rehmi/BottleNode/NodeTest/nodes.csv

Node | Name
00 | esp32-3485188d8ad8
01 | esp32-3485188d9920
02 | esp32-34851891bfc4
03 | esp32-34851891bf58
04 | esp32-3485188da08c
05 | esp32-3485188caddc
06 | esp32-3485188d91a8
07 | esp32-34851891bc4c
08 | esp32-3485188d86b0
09 | esp32-34851891b4d8
10 | esp32-3485188f55c0
11 | esp32-3485188d8ad0
12 | esp32-34851891b4b4
13 | esp32-34851891bb1c
14 | esp32-34851891bed0
15 | esp32-3485188d897c
16 | esp32-34851891c810
