rehmi/BottleNode/TODO.md

# Capabilities to add

* local filesystem
* play stream from local file
* WebDAV to access local filesystem
* push local file to WebDAV server
* functions to open/close local file, start/stop recording from mic to file
