rehmi/BottleNode/hw/BottleNode/BottleNode-schematic.pdf

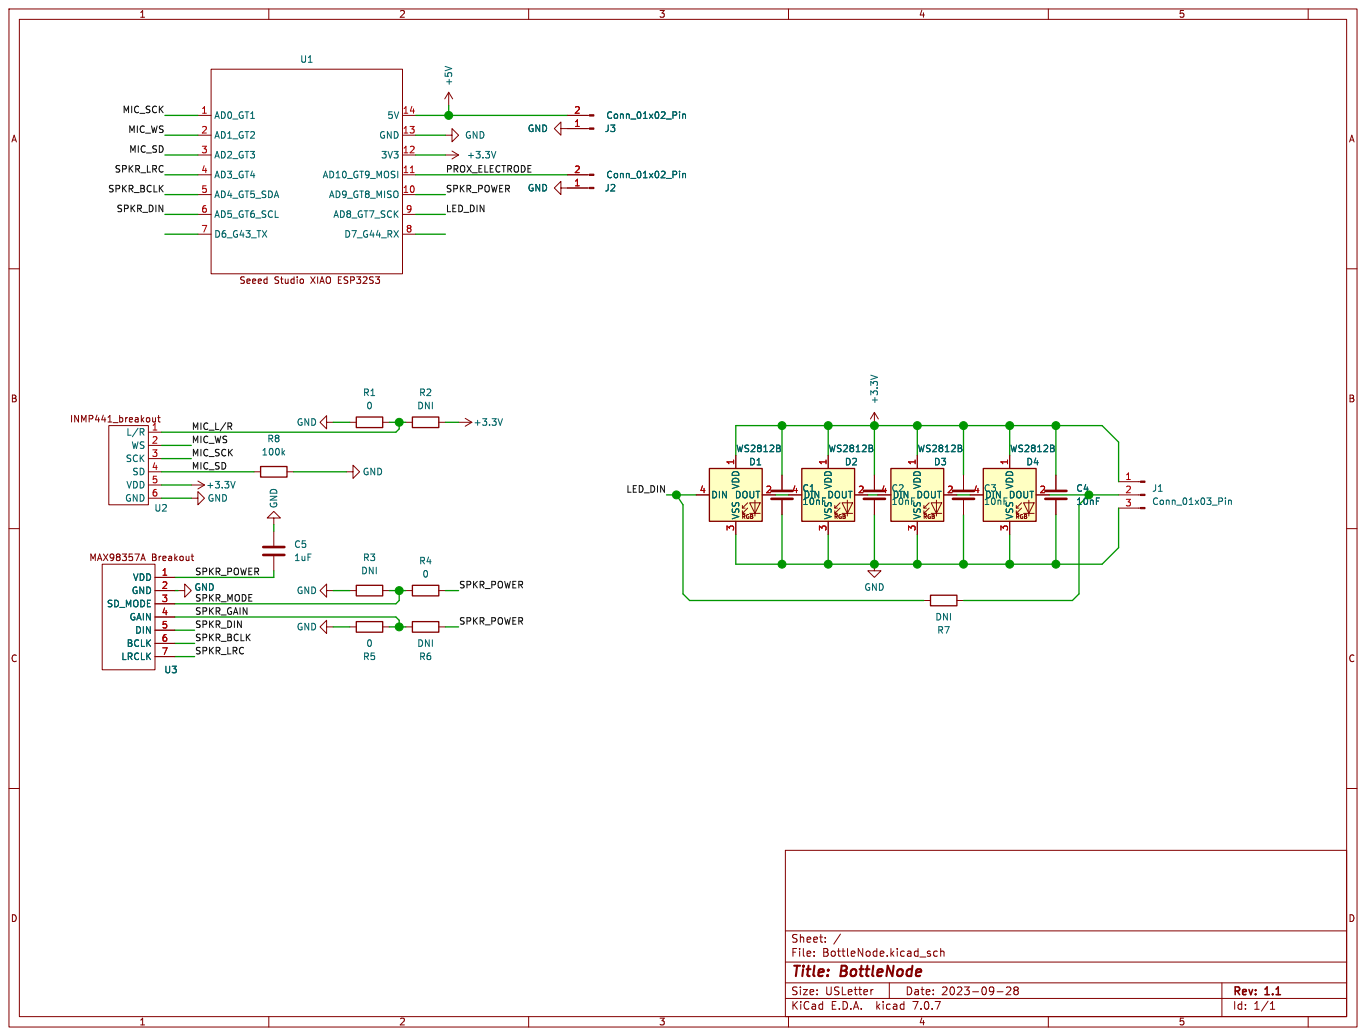
[picture p3: page 1]
