rehmi/BottleNode/hw/BottleNode/BottleNode.kicad_pcb

## KiCad design hw/BottleNode/BottleNode.kicad_pcb (2023-09-30)

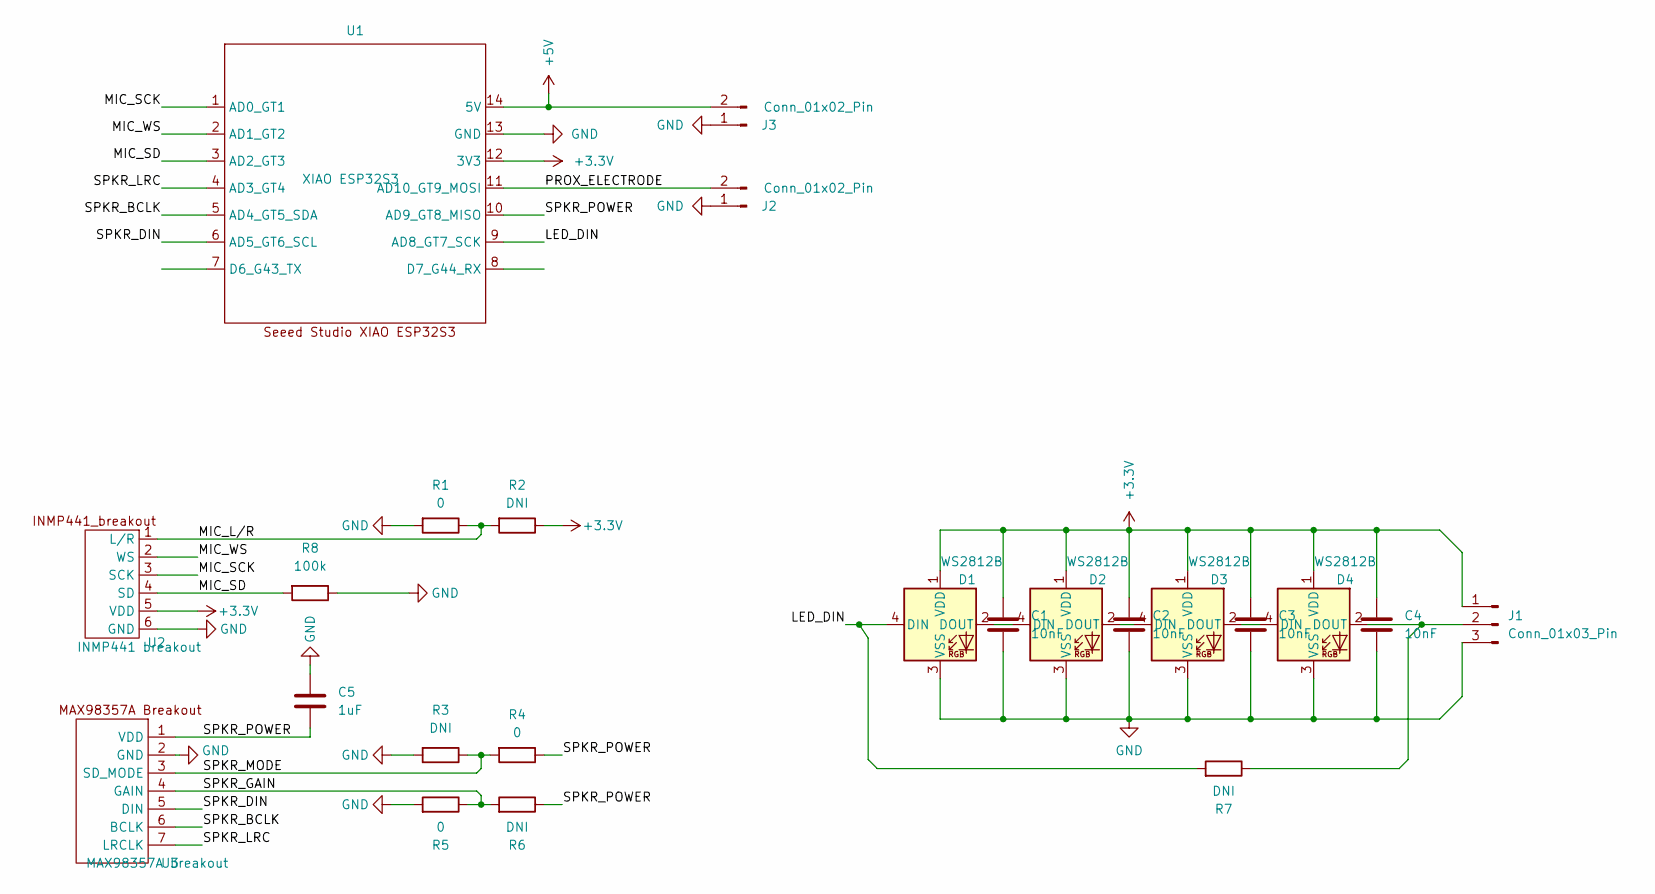
[picture p4: schematic BottleNode.kicad_sch]

Parts:
C1, C2, C3, C4: 10nF; C_0603_1608Metric_Pad1.08x0.95mm_HandSolder
C5: 1uF; C_0603_1608Metric_Pad1.08x0.95mm_HandSolder
D1, D2, D3, D4: WS2812B; LED_WS2812B_PLCC4_5.0x5.0mm_P3.2mm
J1: Conn_01x03_Pin; PinHeader_1x03_P2.54mm_Vertical
J2, J3: Conn_01x02_Pin; PinHeader_1x02_P2.54mm_Vertical
R1, R4, R5: 0; R_0603_1608Metric_Pad0.98x0.95mm_HandSolder
R2, R3, R6, R7: DNI; R_0603_1608Metric_Pad0.98x0.95mm_HandSolder
R8: 100k; R_0603_1608Metric_Pad0.98x0.95mm_HandSolder
U1: XIAO ESP32S3; XIAO-Generic-Thruhole-14P-2.54-21X17.8MM
U2: INMP441 breakout; INMP441_breakout
U3: MAX98357A breakout; MAX98357A_adafruit_breakout

Connections:
+3.3V: C1.1, C2.1, C3.1, C4.1, D1.1 (VDD), D2.1 (VDD), D3.1 (VDD), D4.1 (VDD), J1.1, R2.1, U1.12 (3V3), U2.5 (VDD)
+5V: J3.2, U1.14 (5V)
/LED_DIN: D1.4 (DIN), R7.2, U1.9 (AD8_GT7_SCK)
/MIC_L/R: R1.1, R2.2, U2.1 (L/R)
/MIC_SCK: U1.1 (AD0_GT1), U2.3 (SCK)
/MIC_SD: R8.2, U1.3 (AD2_GT3), U2.4 (SD)
/MIC_WS: U1.2 (AD1_GT2), U2.2 (WS)
/PROX_ELECTRODE: J2.2, U1.11 (AD10_GT9_MOSI)
/SPKR_BCLK: U1.5 (AD4_GT5_SDA), U3.6 (BCLK)
/SPKR_DIN: U1.6 (AD5_GT6_SCL), U3.5 (DIN)
/SPKR_GAIN: R5.1, R6.2, U3.4 (GAIN)
/SPKR_LRC: U1.4 (AD3_GT4), U3.7 (LRCLK)
/SPKR_MODE: R3.1, R4.2, U3.3 (SD_MODE)
/SPKR_POWER: C5.2, R4.1, R6.1, U1.10 (AD9_GT8_MISO), U3.1 (VDD)
GND: C1.2, C2.2, C3.2, C4.2, C5.1, D1.3 (VSS), D2.3 (VSS), D3.3 (VSS), D4.3 (VSS), J1.3, J2.1, J3.1, R1.2, R3.2, R5.2, R8.1, U1.13 (GND), U2.6 (GND), U3.2 (GND)
unnamed: D1.2 (DOUT), D2.4 (DIN)
unnamed: D2.2 (DOUT), D3.4 (DIN)
unnamed: D3.2 (DOUT), D4.4 (DIN)
unnamed: D4.2 (DOUT), J1.2, R7.1

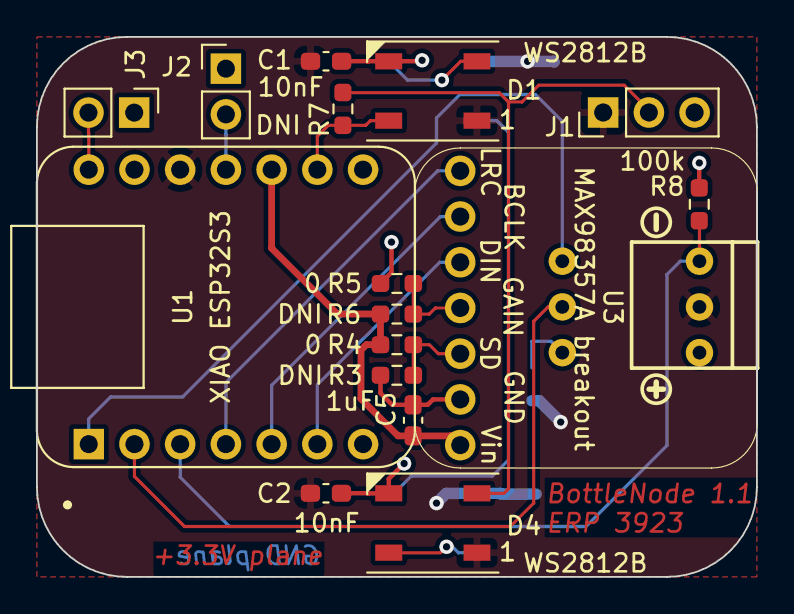
[picture p5: board BottleNode.kicad_pcb from above]

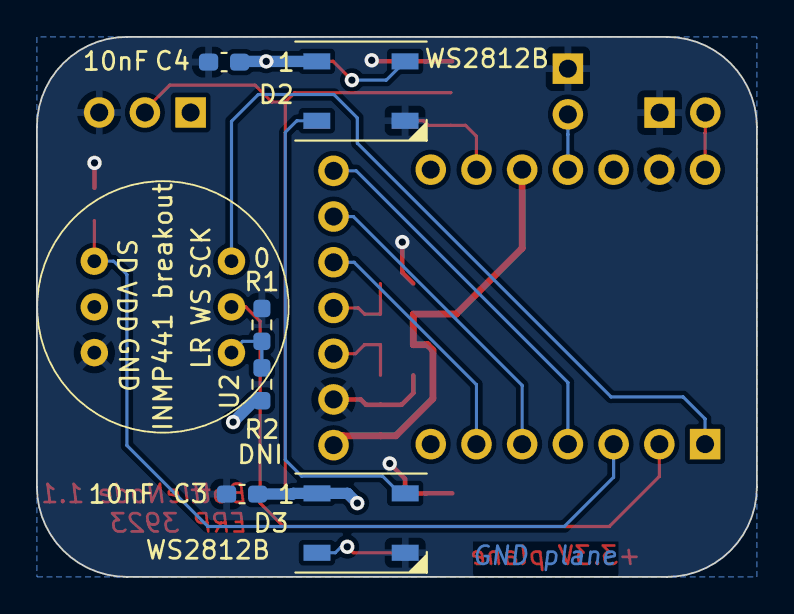
[picture p6: board BottleNode.kicad_pcb from below]

Board: 2 copper layers, 40.0 x 30.0 mm, 23 parts (7 on the bottom side), 19 nets.
