rehmi/BottleNode/Live/audio.cpp

#include "globals.h"
#include "FS.h"
#include "SPIFFS.h"
// Audio status functions
// Create audio object
Audio audio;
int fact = 50;
int dVal = 8*fact;
int toFade = 0;
int toLoop = 0;
char tFS[256];
char tFSC[256]="/C.mp3";
char tFSE[256]="/E.mp3";
char tFSG[256]="/G.mp3";
char tFSUse[256];

void listDir(fs::FS &fs, const char * dirname, uint8_t levels){
    Serial.printf("Listing directory: %s\r\n", dirname);

    File root = fs.open(dirname);
    if(!root){
        Serial.println("- failed to open directory");
        return;
    }
    if(!root.isDirectory()){
        Serial.println(" - not a directory");
        return;
    }

    File file = root.openNextFile();
    while(file){
        if(file.isDirectory()){
            Serial.print("  DIR : ");
            Serial.println(file.name());
            if(levels){
                listDir(fs, file.path(), levels -1);
            }
        } else {
            Serial.print("  FILE: ");
            Serial.print(file.name());
            Serial.print("\tSIZE: ");
            Serial.println(file.size());
        }
        file = root.openNextFile();
    }
}

bool check_if_file_exists(fs::FS &fs, const char *fName)  {
  bool exists = false;
  Serial.printf("Checking file exists: %s\r\n", fName);

    File file = fs.open(fName);
    if(!file){
        Serial.println("- failed to find file");
    } else{
      exists = true;
    }
    file.close();
    return exists;
}

void audio_info(const char *info) {
    Serial.print("info        ");
    Serial.println(info);
}
void audio_id3data(const char *info) {  // id3 metadata
    Serial.print("id3data     ");
    Serial.println(info);
}
void audio_eof_mp3(const char *info) {  // end of file
    Serial.print("eof_mp3     ");
    Serial.println(info);
}
void audio_showstation(const char *info) {
    Serial.print("station     ");
    Serial.println(info);
}
void audio_showstreaminfo(const char *info) {
    Serial.print("streaminfo  ");
    Serial.println(info);
}
void audio_showstreamtitle(const char *info) {
    Serial.print("streamtitle ");
    Serial.println(info);
}
void audio_bitrate(const char *info) {
    Serial.print("bitrate     ");
    Serial.println(info);
}
void audio_commercial(const char *info) {  // duration in sec
    Serial.print("commercial  ");
    Serial.println(info);
}
void audio_icyurl(const char *info) {  // homepage
    Serial.print("icyurl      ");
    Serial.println(info);
}
void audio_lasthost(const char *info) {  // stream URL played
    Serial.print("lasthost    ");
    Serial.println(info);
}
void audio_eof_speech(const char *info) {
    Serial.print("eof_speech  ");
    Serial.println(info);
}

void set_audio_url(char * in, int len) {
  char url[len];
  toFade = 0;
  Serial.println("Connecting to host: ");
  for(int i = 0; i < len; i++) {
        url[i]=in[i];
    }
  audio.connecttohost(url);
}

void set_audio_fs(char * in, int len) {
  char url[len];
  toFade = 0;
  toLoop = 1;
  Serial.println("Connecting to host: ");
  for(int i = 0; i < len; i++) {
        url[i]=in[i];
    }
  strcpy(tFSUse, url);
  audio.connecttoFS(SPIFFS, tFSUse); // SPIFFS

  Serial.println("Playing FS: ");
  Serial.println(tFSUse);
}

void set_audio_volume(uint8_t * in) {
    audio.setVolume(*in);
}

int fade_out() {
  toFade = 1;
  int off = 0;
  int vol = audio.getVolume();
  float div = (float)dVal/(float)fact;
  audio.setVolume((int)div);
  dVal--;
  if (vol <= 0) {
    off = 1;
  } 
  return off;
}

void stop_audio(void) {
    if (audio.isRunning())  {
      // fade_out();
      toFade = 1;
      toLoop = 0;
      audio.stopSong();
    }
}

void setup_audio(void)
{
    strcpy(tFSUse, tFSC);
    digitalWrite(SPKR_POWER, 0);
    gpio_set_drive_capability(SPKR_POWER, GPIO_DRIVE_CAP_3);
    pinMode(SPKR_POWER, OUTPUT);
    digitalWrite(SPKR_POWER, 1);

    // Connect MAX98357 I2S Amplifier Module
    audio.setPinout(SPKR_BCLK, SPKR_LRC, SPKR_DIN);

    // Set thevolume (0-100)
    audio.setVolume(18);

    audio.setConnectionTimeout(15000, 15000);

    // Connect to an Internet radio station (select one as desired)
    // audio.connecttohost("http://vis.media-ice.musicradio.com/CapitalMP3");
    // audio.connecttohost("mediaserv30.live-nect MAX98357 I2S Amplifier Module
    // audio.connecttohost("www.surfmusic.de/m3u/100-5-das-hitradio,4529.m3u");
    // audio.connecttohost("stream.1a-webradio.de/deutsch/mp3-128/vtuner-1a");
    // audio.connecttohost("www.antenne.de/webradio/antenne.m3u");
    // audio.connecttohost("0n-80s.radionetz.de:8000/0n-70s.mp3");

    char URL[] =
        // "http://stream.klassikradio.de/purebach/mp3-128/www.klassikradio.de/";
        // "http://ice1.somafm.com/deepspaceone-64-aac";
        // "http://ice1.somafm.com/dronezone-128-mp3";
        "https://ice4.somafm.com/dronezone-32-aac";
    // "http://38.96.148.28:8342/stream";
        audio.connecttohost(URL);

    #define FORMAT_SPIFFS_IF_FAILED true

    if(!SPIFFS.begin(FORMAT_SPIFFS_IF_FAILED)){
        Serial.println("SPIFFS Mount Failed");
        return;
    }
    
    listDir(SPIFFS, "/", 0);

    // Check if file exists 
    if(!check_if_file_exists(SPIFFS, tFSUse))  {
        strcpy(tFSUse, tFSE);
        audio.setVolume(15);
      if (!check_if_file_exists(SPIFFS, tFSE))  {
        strcpy(tFSUse, tFSG);
        audio.setVolume(15);
      }
      if (!check_if_file_exists(SPIFFS, tFSG))  {
        audio.setVolume(8);
      }
    }

    //  *** radio streams ***
    // while (!audio.connecttohost(URL))
    //     ;

    //  audio.connecttohost("http://stream.antennethueringen.de/live/aac-64/stream.antennethueringen.de/"); // aac
    //  audio.connecttohost("http://mcrscast.mcr.iol.pt/cidadefm");                                         // mp3
    //  audio.connecttohost("http://www.wdr.de/wdrlive/media/einslive.m3u");                                // m3u
    //  audio.connecttohost("https://stream.srg-ssr.ch/rsp/aacp_48.asx");                                   // asx
    //  audio.connecttohost("http://tuner.classical102.com/listen.pls");                                    // pls
    //  audio.connecttohost("http://stream.radioparadise.com/flac");                                        // flac
    //  audio.connecttohost("http://stream.sing-sing-bis.org:8000/singsingFlac");                           // flac (ogg)
    //  audio.connecttohost("http://s1.knixx.fm:5347/dein_webradio_vbr.opus");                              // opus (ogg)
    //  audio.connecttohost("http://stream2.dancewave.online:8080/dance.ogg");                              // vorbis (ogg)
    //  audio.connecttohost("http://26373.live.streamtheworld.com:3690/XHQQ_FMAAC/HLSTS/playlist.m3u8");    // HLS
    //  audio.connecttohost("http://eldoradolive02.akamaized.net/hls/live/2043453/eldorado/master.m3u8");   // HLS (ts)
    //  *** web files ***
    //  audio.connecttohost("https://github.com/schreibfaul1/ESP32-audioI2S/raw/master/additional_info/Testfiles/Pink-Panther.wav");        // wav
    //  audio.connecttohost("https://github.com/schreibfaul1/ESP32-audioI2S/raw/master/additional_info/Testfiles/Santiano-Wellerman.flac"); // flac
    //  audio.connecttohost("https://github.com/schreibfaul1/ESP32-audioI2S/raw/master/additional_info/Testfiles/Olsen-Banden.mp3");        // mp3
    //  audio.connecttohost("https://github.com/schreibfaul1/ESP32-audioI2S/raw/master/additional_info/Testfiles/Miss-Marple.m4a");         // m4a (aac)
    //  audio.connecttohost("https://github.com/schreibfaul1/ESP32-audioI2S/raw/master/additional_info/Testfiles/Collide.ogg");             // vorbis
    //  audio.connecttohost("https://github.com/schreibfaul1/ESP32-audioI2S/raw/master/additional_info/Testfiles/sample.opus");             // opus
    //  *** local files ***
    //  audio.connecttoFS(SD, "/test.wav");     // SD
    //  audio.connecttoFS(SD_MMC, "/test.wav"); // SD_MMC
    //  audio.connecttoFS(SPIFFS, "/test.wav"); // SPIFFS

    //  audio.connecttospeech("Wenn die Hunde schlafen, kann der Wolf gut Schafe stehlen.", "de"); // Google TTS


}

void loop_audio(void)
{   
    // Set thevolume (0-100)
    // audio.setVolume(min(6, (int)(touchfactor *  12)));
    audio.loop();

    if (touchfactor > 0.75)  {
      if(check_if_file_exists(SPIFFS, tFSUse))  {
        audio.connecttoFS(SPIFFS, tFSUse); // SPIFFS 
      } else  {
        audio.connecttospeech("Hello there!", "en"); // Google TTS
      }
    }

    if(toLoop == 1){
      Serial.println("restarting audio loop FS");
      if (!audio.isRunning()) {
      audio.connecttoFS(SPIFFS, tFSUse); // SPIFFS 
      }
    }

    // Ensure there is always music
    if (!audio.isRunning()) {
      audio.connecttoFS(SPIFFS, "default.aac"); // SPIFFS 
    }

    // Run audio player
    // if (toFade == 0)  {
    //   audio.loop();
    // }

    // Check if need to fade off 
    // if (toFade == 1)  {
    //   int off = fade_out();
    //   if (off == 1 )  {
    //     toFade = 0;
    //     dVal = 8*fact;
    //     audio.stopSong();
    //   }
    // }
}
