rehmi/BottleNode/Live/webdav.cpp

#include "globals.h"

/*
    Copyright (c) 2018 Gurpreet Bal https://github.com/ardyesp/ESPWebDAV
    Copyright (c) 2020 David Gauchard https://github.com/d-a-v/ESPWebDAV
    All rights reserved.

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
    1. Redistributions of source code must retain the above copyright notice,
      this list of conditions and the following disclaimer.
    2. Redistributions in binary form must reproduce the above copyright notice,
      this list of conditions and the following disclaimer in the documentation
      and/or other materials provided with the distribution.
    3. The name of the author may not be used to endorse or promote products
      derived from this software without specific prior written permission.

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
*/

/*  Using the WebDAV server

    From windows file explorer,
        \\ESPWebDAV.local\
        or http://ESPWebDAV.local/
        or Map Network Drive -> Connect to http://ESPWebDAV.local/
           subst w: \\ESPWebDAV.local/DavWWWRoot
    From macOS Finder > command-K > http://ESPWebDAV.local/
        (do not select anonymous to have write access)
    From macOS cmdline:
        mkdir -p /tmp/esp; mount_webdav -S -i -v esp32 http://ESPWebDAV.local/ /tmp/esp && echo OK
    From linux:
        use mount -t davs2 http://ESPWebDAV.local/ /mnt/
        use gio/gvfs/nautilus/YourFileExplorer http://ESPWebDAV.local/

    When running emulation on host (script ./run), use one of these URLs instead:
        http://ESPWebDAV.local:9080/
        http://127.0.0.1:9080/
        http://local-ip-address:9080/
        subst w: \\ESPWebDAV.local@9080/DavWWWRoot
*/

#include <WiFi.h>
#include <ESPmDNS.h>
#include <SPIFFS.h>
//#include <LITTLEFS.h>
#include <ESPWebDAV.h>

//FS& gfs = LITTLEFS;
//#define FILESYSTEM LITTLEFS
#define FILESYSTEM SPIFFS

//WiFiServerSecure tcp(443);
WiFiServer tcp(80);

ESPWebDAV dav;

// ------------------------
void setup_webdav()
{
    // MDNS.begin("ESPWebDAV");

    FILESYSTEM.begin();
    tcp.begin();
    dav.begin(&tcp, &FILESYSTEM);
    dav.setTransferStatusCallback([](const char* name, int percent, bool receive)
    {
        Serial.printf("%s: '%s': %d%%\n", receive ? "recv" : "send", name, percent);
    });

    Serial.println("WebDAV server started");
}

void help()
{
    Serial.printf("interactive: F/ormat D/ir C/reateFile\n");

    Serial.printf("Heap stats: free heap: %u\n",
                  ESP.getHeapSize());
}

// ------------------------
void loop_webdav()
{
    dav.handleClient();

    int c = Serial.read();
    if (c > 0)
    {
        if (c == 'F')
        {
            Serial.println("formatting...");
            if (FILESYSTEM.format())
                Serial.println("Success");
            else
                Serial.println("Failure");
        }
        else if (c == 'D')
        {
            Serial.printf(">>>>>>>> dir /\n");
            dav.dir("/", &Serial);
            Serial.printf("<<<<<<<< dir\n");
        }
        else if (c == 'C')
        {
            auto f = FILESYSTEM.open("/readme.md", "w");
            f.printf("hello\n");
            f.close();
        }
        else
            help();
    }

    // ------------------------
}
