rehmi/BottleNode/(commit log)

2023-09-19 preliminary schematic and PCB layout
    [BottleNode.kicad_pcb, BottleNode.kicad_sch]
2023-09-19 schematic and code fragments now agree on pinouts
    [BottleNode.kicad_pcb, BottleNode.kicad_sch]
2023-09-21 AllInOne_test = I2S passthru + LEDs + cap sensing
2023-09-21 swap SPKR_POWER/TOUCH_PIN in AllInOne_test/sch/pcb
    [BottleNode.kicad_pcb, BottleNode.kicad_sch]
2023-09-28 update LED behavior in OSC.cpp stub
2023-09-28 update BottleNode-schematic.pdf to match .sch file
2023-09-28 pin defs now in globals.h; added myAudioI2S.cpp
2023-09-29 rev 1.1 of schematic and PCB layout with BOM
    [BottleNode.csv, BottleNode.kicad_pcb, BottleNode.kicad_sch]
2023-09-29 updated schematic PDF and 3D renderings
2023-09-29 final tweaks on PCB v1.1
    [BottleNode.kicad_pcb, BottleNode.kicad_sch]
2023-09-30 rev 1.1.1 - move config resistors away from header
    [BottleNode.kicad_pcb, BottleNode.kicad_sch]
2023-10-04 Functional LED/Wifi
    Function WIFI and LED on my local esp32.
2023-10-06 Adding in IP addrss getting from arduino and max
2023-10-09 Adding batch send to send commands to all devices rather than just one
2023-10-09 Adding a pusher for current IP addresses as they respond to a request to identify
2023-10-11 Adding in capability for touchfactor feedback. Also fixed bug with loop_i2s(). Also cleaned up Max layout. And separated the commands so they are ip specific.
    [OSCL.cpp, WiFi_OTA.cpp, globals.h, touch.cpp]
2023-10-11 Removing IP address fixing and Adding sound tracks
    [Live.ino, OSCL.cpp, WiFi_OTA.cpp, audio.cpp, globals.h, touch.cpp]
2023-10-12 AllInOne_test for initial group testing
    [nodes.csv]
2023-10-12 switch to 32kbps test stream
2023-10-12 NodeTest now plays from SPIFFS (/default.aac)
    [nodes.csv]
